mar0x/patch_mate/docs/images/image17.jpg

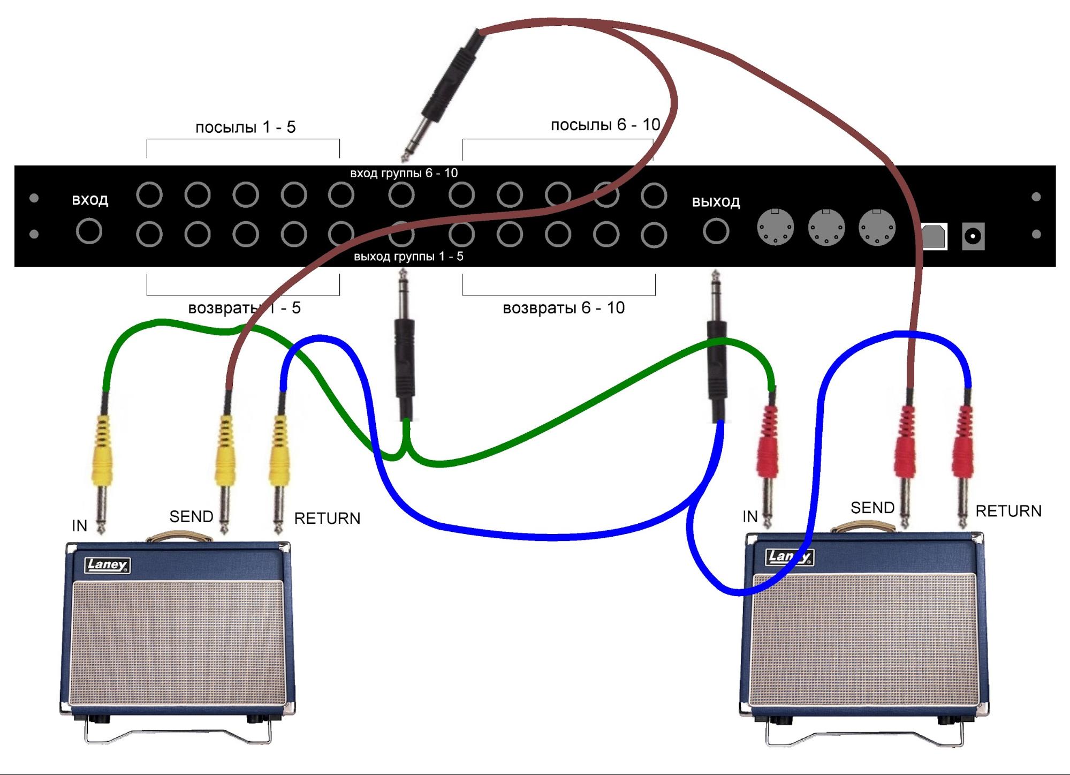
docs/images/image17.jpg
