mar0x/patch_mate/docs/images/image10.png

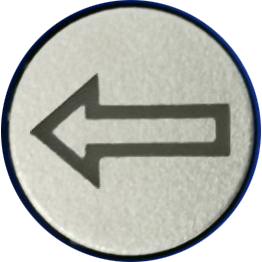
docs/images/image10.png
