mar0x/patch_mate/CHANGELOG.md

## Version FW-2021.12.26

### Bug fixes

- some SysEx messages may pass incomplete from MIDI to USB;

## Version FW-2021.12.24

### New features

- change active preset with encoder, holding LEFT key is optional;
