mar0x/patch_mate/img/Надписи 2.pdf

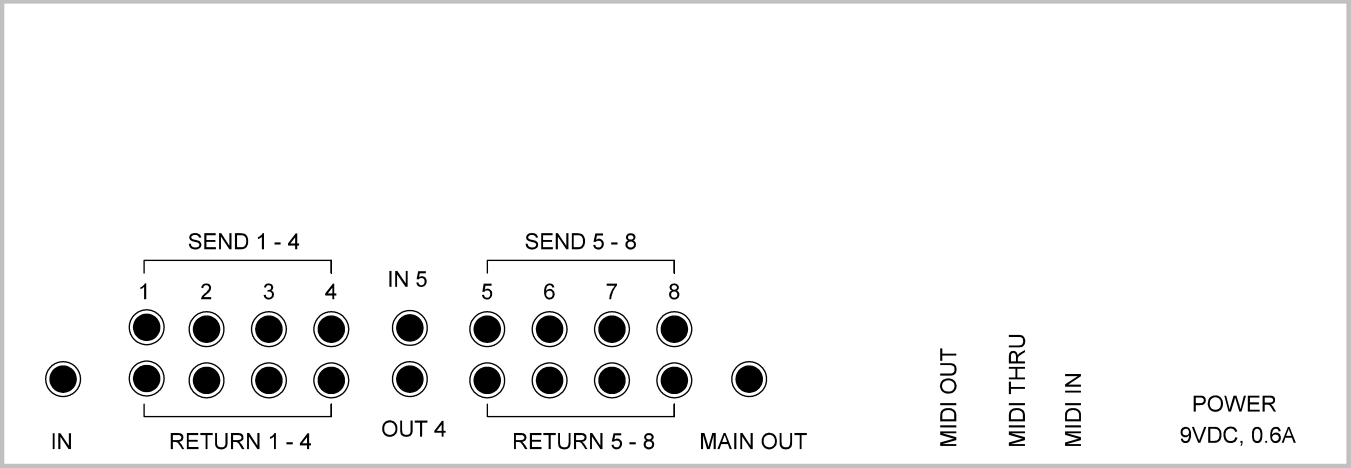
[picture p34: page 1]
