mar0x/patch_mate/docs/images/image13.jpg

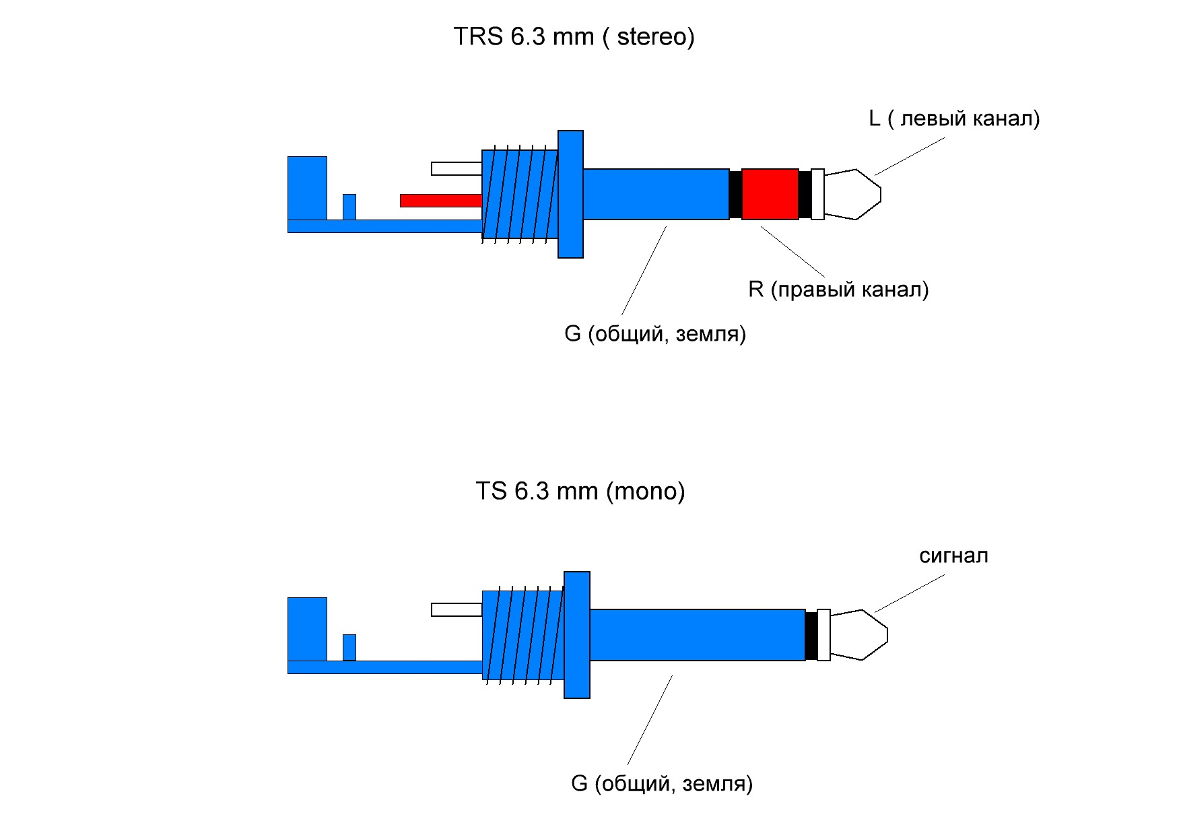
docs/images/image13.jpg
