mar0x/patch_mate/img/patch_mate_8_face.png

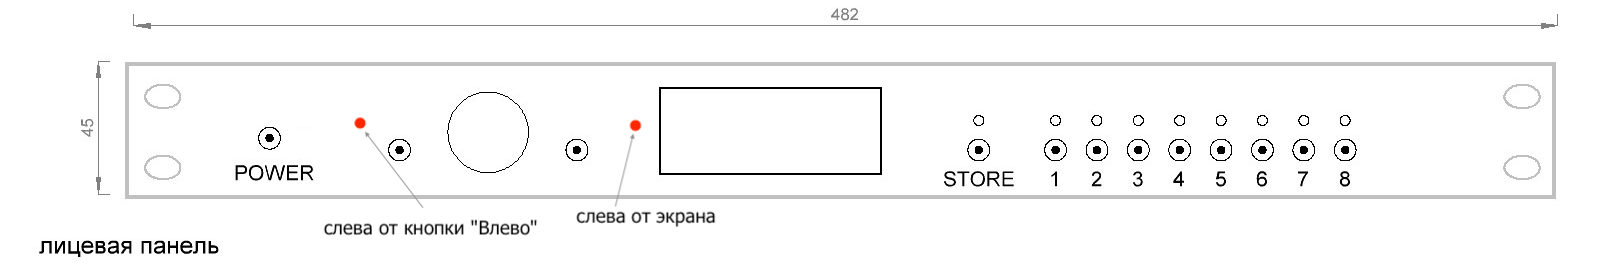
img/patch_mate_8_face.png
