mar0x/patch_mate/img/компоновка 3.JPG

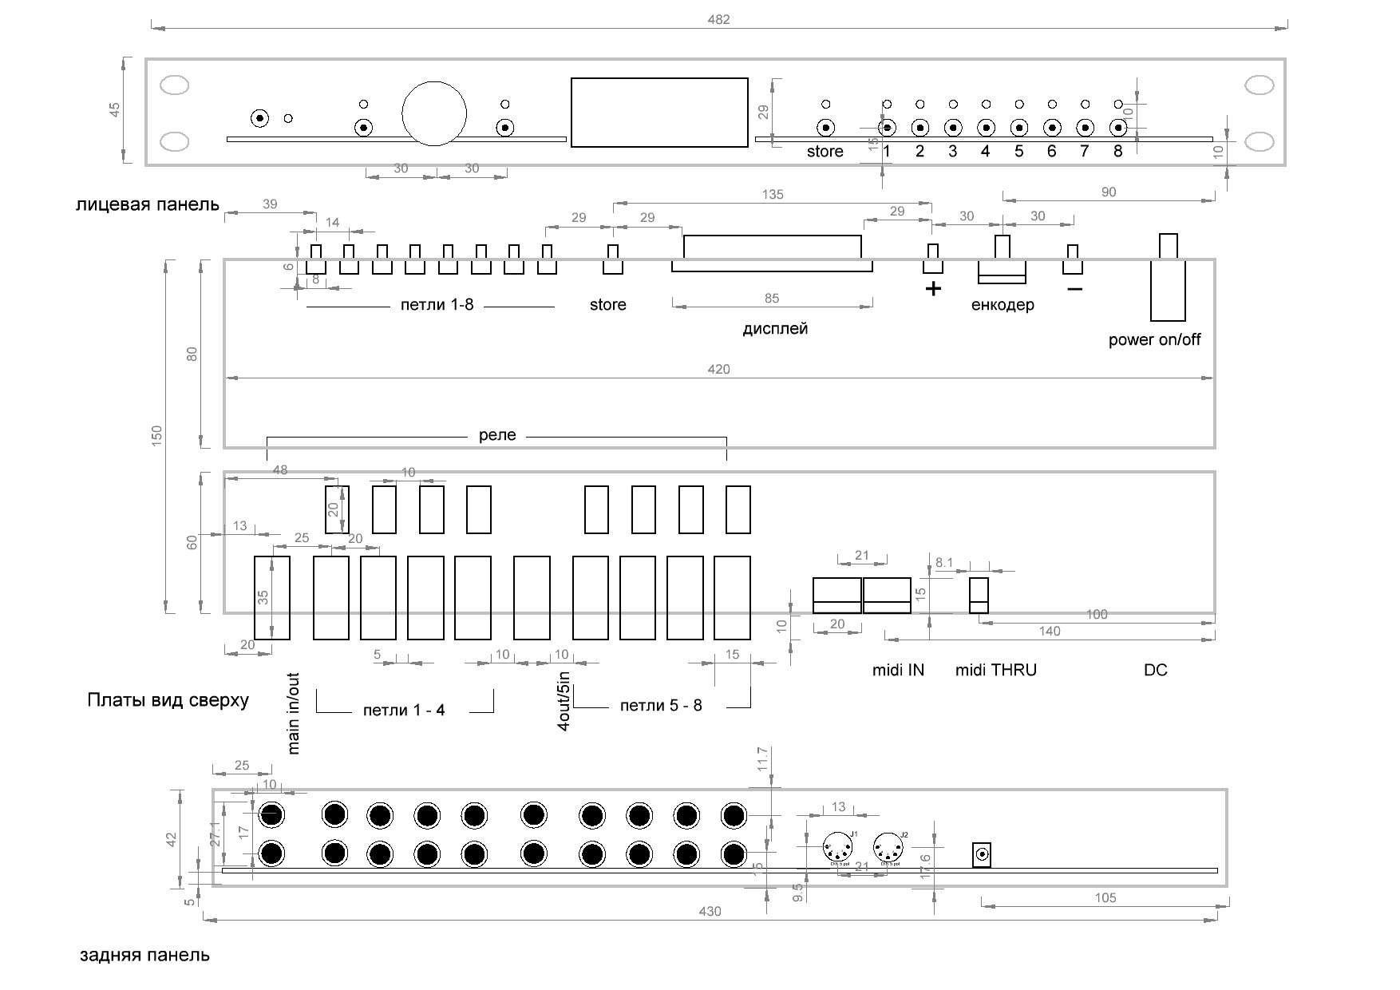
img/компоновка 3.JPG
