mar0x/patch_mate/img/компоновка 4.JPG

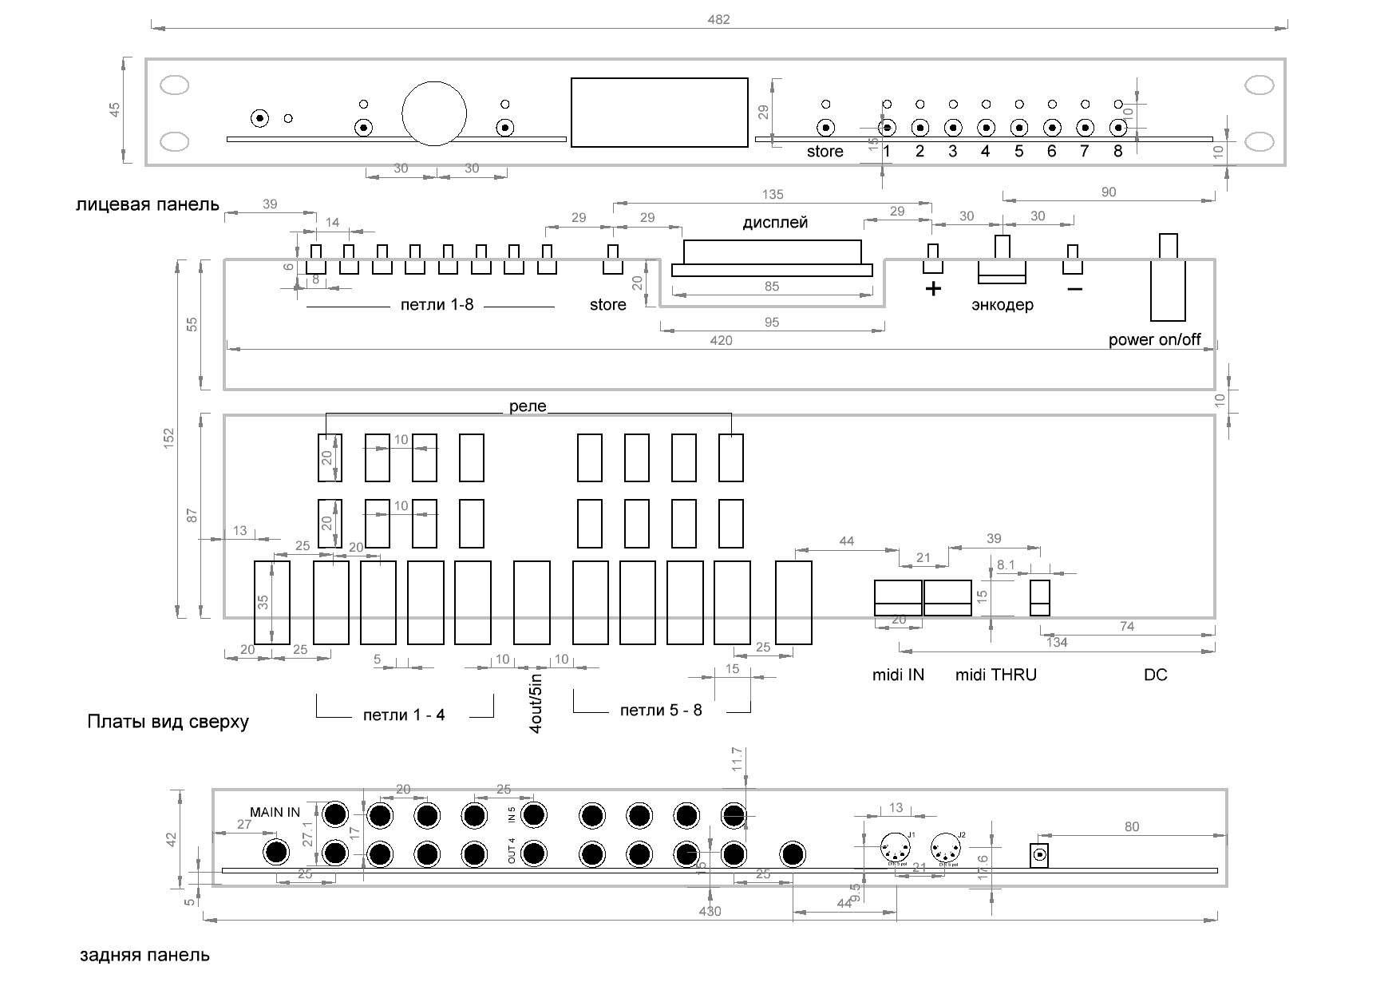
img/компоновка 4.JPG
