mar0x/patch_mate/img/надписи на крышке.JPG

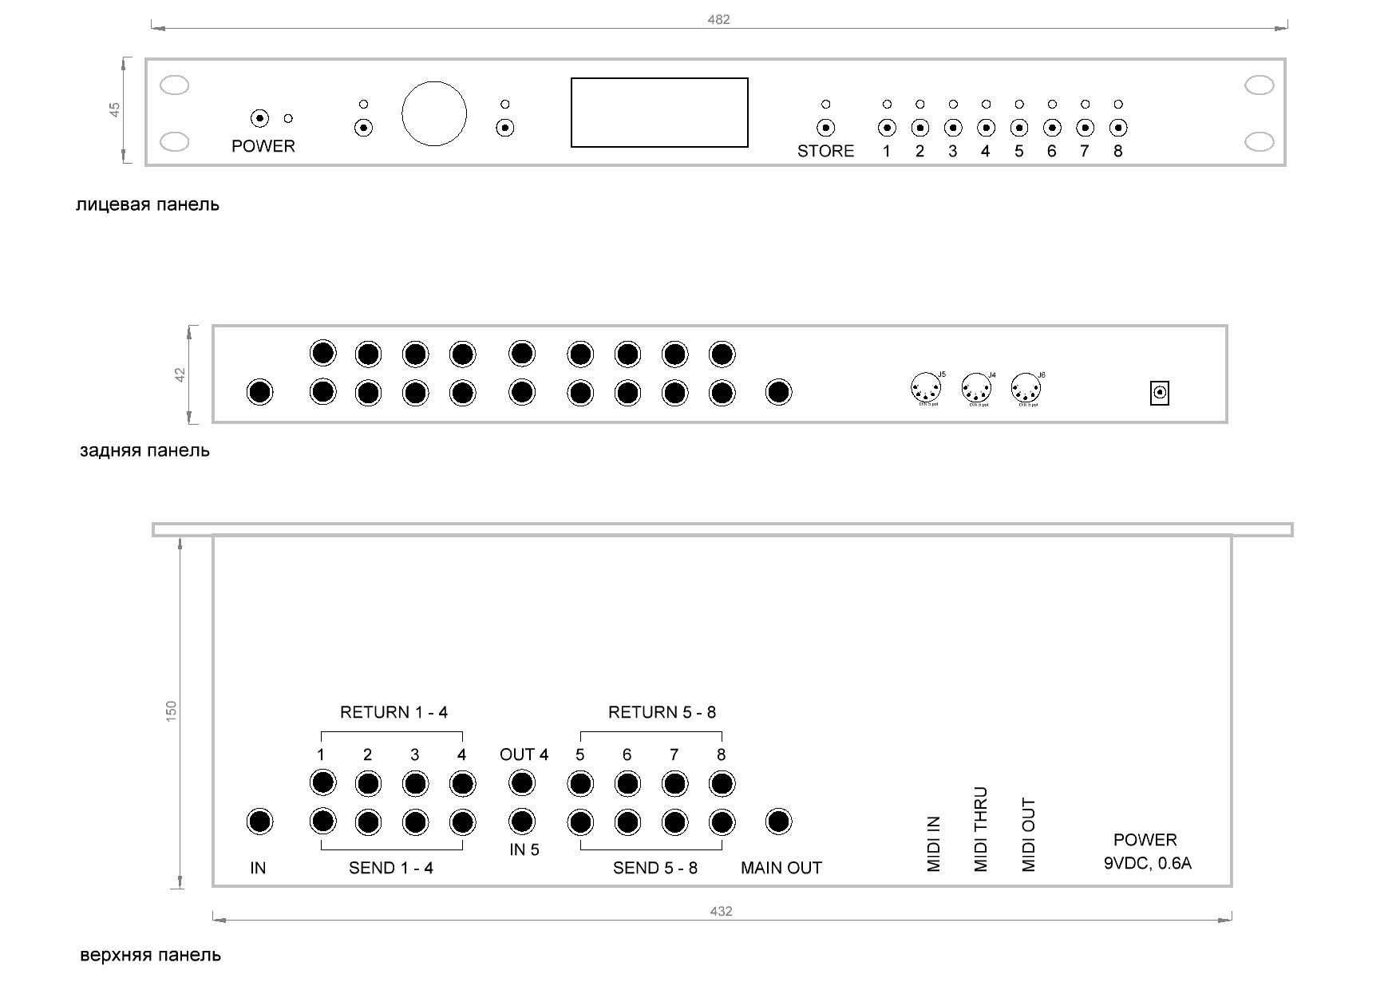
img/надписи на крышке.JPG
