mar0x/patch_mate/patch_mate-bom.xlsx

id | q | ref | desc | size | Vendor |  | Order info
 |  |  |  |  | URL | code | # | date | price | count | shipping | cost | cost per item
Control board
22 pF | 2 | C1,C2 | Кер.ЧИП конд. 22пФ NPO 50В, 5% | 0805 | CC0805JRNPO9BN220 (https://www.terraelectronica.ru/product/540614) | #540614 (https://www.terraelectronica.ru/product/540614) |  |  | 0.40 | 1 |  | 0.40 | 0.80
0.1 uF | 9 | C3,C5,C6,C7,C8,C9,C10,C11,C12 | Кер.ЧИП конд. 0.1 мкФ X7R 50В, 10% | 0805 | 08051C104KAT2A (https://www.terraelectronica.ru/product/684373) | #684373 (https://www.terraelectronica.ru/product/684373) |  |  | 1.20 | 1 |  | 1.20 | 10.80
1 uF | 1 | C4 | Кер.ЧИП конд. 1 мкФ X7R 16В, 10% | 0805 | CC0805KKX7R7BB105 (https://www.terraelectronica.ru/product/576615) | #576615 (https://www.terraelectronica.ru/product/576615) |  |  | 0.59 | 1 |  | 0.59 | 0.59
JST B2B-XH-A | 1 | J1 | 2.5mm |  | JST XH 2.5 mm 2 pin (https://aliexpress.ru/item/32823245600.html) |  |  |  | 1.45 | 100 | 75.00 | 220.00 | 2.20
JST B11B-PH-K-S | 1 | J2 | 2.0mm |  | JST 2.0 mm 11 pin (https://aliexpress.ru/item/33013582664.html) |  | #5003346814132510 (https://trade.aliexpress.ru/order_detail.htm?orderId=5003346814132510) | 2020-03-11 | 10.31 | 20 |  | 206.13 | 10.31
JST B4B-PH-K-S | 1 | J3 | 2.0mm |  | JST 2.0 mm 4 pin (https://aliexpress.ru/item/33013582664.html) |  | #5003346814132510 (https://trade.aliexpress.ru/order_detail.htm?orderId=5003346814132510) | 2020-03-11 | 5.85 | 20 |  | 117.10 | 5.85
JST B5B-PH-K-S | 1 | J4 | 2.0mm |  | JST 2.0 mm 5 pin (https://aliexpress.ru/item/33013582664.html) |  | #5003346814132510 (https://trade.aliexpress.ru/order_detail.htm?orderId=5003346814132510) | 2020-03-11 | 6.50 | 20 |  | 129.93 | 6.50
DS1013-06S | 1 | J5 | Вилка на плату прямая 6 конт. 2.54мм |  | DS1013-06SSiB1-B-0 (https://www.terraelectronica.ru/product/2739747) | #2739747 (https://www.terraelectronica.ru/product/2739747) |  |  | 3.90 | 1 |  | 3.90 | 3.90
JST B6B-PH-K-S | 1 | J6 | 2.0mm |  | JST 2.0 mm 6 pin (https://aliexpress.ru/item/33013582664.html) |  | #5003346814132510 (https://trade.aliexpress.ru/order_detail.htm?orderId=5003346814132510) | 2020-03-11 | 7.18 | 20 |  | 143.57 | 7.18
JST B7B-PH-K-S | 1 | J7 | 2.0mm |  | JST 2.0 mm 7 pin (https://aliexpress.ru/item/33013582664.html) |  | #5003346814132510 (https://trade.aliexpress.ru/order_detail.htm?orderId=5003346814132510) | 2020-03-11 | 7.94 | 20 |  | 158.80 | 7.94
1 kOhm | 13 |  | Чип резистор (SMD), 1 кОм, 0.125Вт, 1% | 0805 | RC0805FR-071KL (https://www.terraelectronica.ru/product/564131) | #564131 (https://www.terraelectronica.ru/product/564131) |  |  | 0.17 | 1 |  | 0.17 | 2.21
22 Ohm | 2 | R12,R13 | Чип резистор (SMD), 22 Ом, 0.125Вт, 1% | 0805 | RC0805FR-0722RL (https://www.terraelectronica.ru/product/851624) | #851624 (https://www.terraelectronica.ru/product/851624) |  |  | 0.12 | 1 |  | 0.12 | 0.24
10 kOhm | 2 | R14,R15 | Чип резистор (SMD), 10 кОм, 0.125Вт, 1% | 0805 | RC0805FR-0710KL (https://www.terraelectronica.ru/product/358763) | #358763 (https://www.terraelectronica.ru/product/358763) |  |  | 0.17 | 1 |  | 0.17 | 0.34
39 kOhm | 15 |  | Чип резистор (SMD), 39 кОм, 0.125Вт, 1% | 0805 | CR-05FL7---39K (https://www.terraelectronica.ru/product/2782305) | #2782305 (https://www.terraelectronica.ru/product/2782305) |  |  | 0.13 | 1 |  | 0.13 | 1.95
PEC16-2215F-N0024 | 1 |  | Энкодер инкрементный |  | PEC16-2215F-N0024 (https://www.terraelectronica.ru/product/577148) | #577148 (https://www.terraelectronica.ru/product/577148) |  |  | 44.80 | 1 |  | 44.80 | 44.80
ATmega32U4-AU | 1 | U1 | Микроконтроллер 8-Бит, AVR, 16МГц, 32КБ Flash, с USB контроллером | TQFP-44 | ATmega32U4 (https://aliexpress.ru/item/32916694199.html) |  | #3003806113682510 (https://trade.aliexpress.ru/order_detail.htm?orderId=3003806113682510) |  | 228.80 | 5 |  | 1144.00 | 228.80
74HC595 | 3 | U2,U6,U7 | 8-и битный сдвиговый регистр с выходным регистром-защелки и тремя состояниями | SO-16 | SN74HC595DR (https://www.terraelectronica.ru/product/36946) | #36946 (https://www.terraelectronica.ru/product/36946) |  |  | 10.30 | 1 |  | 10.30 | 30.90
USBLC6-2SC6 | 1 | U3 | Защита интерфейса USB от электростатических разрядов | SOT-23-6 | USBLC6-2SC6 (https://www.terraelectronica.ru/product/244787) | #244787 (https://www.terraelectronica.ru/product/244787) |  |  | 4.70 | 1 |  | 4.70 | 4.70
74HC165 | 2 | U4,U5 | 8-битный сдвиговый регистр с параллельным входом, последовательным выходом | SO-16 | SN74HC165DR (https://www.terraelectronica.ru/product/51304) | #51304 (https://www.terraelectronica.ru/product/51304) |  |  | 8.00 | 1 |  | 8.00 | 16.00
AT25640B | 1 | U8 | Микросхема памяти, 64Kb SPI-compatible Serial EEPROM | SO-8 | AT25640B-SSHL-T (https://www.terraelectronica.ru/product/679087) | #679087 (https://www.terraelectronica.ru/product/679087) |  |  | 20.00 | 1 |  | 20.00 | 20.00
SN74LVC1G125DBVR | 1 | U9 | Один буферный элемент с тремя состояниями на выходе | SOT-23-5 | SN74LVC1G125DBVR (https://www.terraelectronica.ru/product/32503) | #32503 (https://www.terraelectronica.ru/product/32503) |  |  | 2.70 | 1 |  | 2.70 | 2.70
HC-49SM | 1 | Y1 | Кварцевый резонатор, 16.000 МГц | HC-49SM | HC-49SM (https://www.chipdip.ru/product/16mhz-hc-49sm) | #375027481 (https://www.chipdip.ru/product/16mhz-hc-49sm) |  |  | 18.00 | 1 |  | 18.00 | 18.00
Relay board
100 uF | 1 | C1 | Конденсатор электролитический алюминиевый, ECAP (К50-35), 100 мкФ, 25 В, 20% | 6.3x11mm | JRC1E101M02500630110000B (https://www.chipdip.ru/product0/9000565756) | #9000565756 (https://www.chipdip.ru/product0/9000565756) |  |  | 5.00 | 1 |  | 5.00 | 5.00
1000 uF | 1 | C2 | Конденсатор электролитический алюминиевый, ECAP (К50-35), 1000 мкФ, 16 В | 10x16mm | B41851A4108M000 (https://www.chipdip.ru/product0/9000306686) | #9000306686 (https://www.chipdip.ru/product0/9000306686) |  |  | 32.00 | 1 |  | 32.00 | 32.00
0.1 uF | 5 | C3,C4,C5,C6,C7 | Кер.ЧИП конд. 0.1 мкФ X7R 50В, 10% | 0805 | 08051C104KAT2A (https://www.terraelectronica.ru/product/684373) | #684373 (https://www.terraelectronica.ru/product/684373) |  |  | 1.20 | 1 |  | 1.20 | 6.00
RS202-BP | 1 | D3 | Diode bridge, +ve/AC/AC/-ve | RS2 | RS202-BP (https://www.terraelectronica.ru/product/2740393) | #2740393 (https://www.terraelectronica.ru/product/2740393) |  |  | 9.70 | 1 |  | 9.70 | 9.70
D | 1 | D4 | Диод импульсный 75 мА 75В 5нс | SOD323F/SC-90 | BAS316.115 (https://www.terraelectronica.ru/product/241389) | #241389 (https://www.terraelectronica.ru/product/241389) |  |  | 0.65 | 1 |  | 0.65 | 0.65
1N5822 | 1 | D5 | Диод Шоттки 40В 3А/80А | DO-201AE | 1N5822 (https://www.terraelectronica.ru/product/154029) | #154029 (https://www.terraelectronica.ru/product/154029) |  |  | 7.20 | 1 |  | 7.20 | 7.20
MF-MSMF050-2 | 1 | F1 | Предохранитель USB VBUS | 1812 | MF-MSMF050-2 (https://www.terraelectronica.ru/product/186713) | #186713 (https://www.terraelectronica.ru/product/186713) |  |  | 2.10 | 1 |  | 2.10 | 2.10
DualJack | 11 |  |  |  | CK635-037 (https://aliexpress.ru/item/32756961680.html) |  | #3003695040752510 (https://trade.aliexpress.ru/order_detail.htm?orderId=3003695040752510) |  | 115.00 | 10 |  | 1150.00 | 1265.00
RTW909080M | 3 | J1,J2,J3 | DIN connector 5 Pin DIN Female Jack Right Angle Panel Mount 90 Degree |  | RTW909080M (https://www.aliexpress.ru/item/10-Pcs-Set-PCB-Panel-Mount-Female-Connector-DIN5-DIN-5-Pin-Jack-DS-5-01/4001264257087.html) |  | #5005159492622510 (https://trade.aliexpress.ru/order_detail.htm?orderId=5005159492622510) | 2020-08-27 | 23.05 | 60 | 141.74 | 1524.86 | 76.24
DS-210B | 1 | J4 | Гнездо питания 2,1х5,5мм на панель |  | DS-210B (https://www.terraelectronica.ru/product/2584473) | #2584473 (https://www.terraelectronica.ru/product/2584473) |  |  | 10.50 | 1 |  | 10.50 | 10.50
JST B2B-XH-A | 1 | J5 | 2.5mm |  | JST XH 2.5 mm 2 pin (https://aliexpress.ru/item/32823245600.html) |  |  |  | 1.45 | 100 |  | 145.00 | 1.45
JST B5B-PH-K-S | 1 | J6 | 2.0mm |  | JST 2.0 mm 5 pin (https://aliexpress.ru/item/33013582664.html) |  | #5003346814132510 (https://trade.aliexpress.ru/order_detail.htm?orderId=5003346814132510) | 2020-03-11 | 6.50 | 20 |  | 129.93 | 6.50
JST B4B-PH-K-S | 1 | J7 | 2.0mm |  | JST 2.0 mm 4 pin (https://aliexpress.ru/item/33013582664.html) |  | #5003346814132510 (https://trade.aliexpress.ru/order_detail.htm?orderId=5003346814132510) | 2020-03-11 | 5.85 | 20 |  | 117.10 | 5.85
JST B4B-XH-A | 1 | J8 | 2.5mm |  | JST XH 2.5 mm 4 pin (https://aliexpress.ru/item/32823245600.html) |  |  |  | 2.07 | 70 |  | 145.00 | 2.07
DS1099 | 1 | J9 | Розетка на плату, тип B (черная) угловая |  | DS1099-BN0 (https://www.chipdip.ru/product/usbb-1j-ds1099-b) | #846814658 (https://www.chipdip.ru/product/usbb-1j-ds1099-b) |  |  | 21.00 | 1 |  | 21.00 | 21.00
 |  |  |  |  | USBB-1J (https://www.terraelectronica.ru/product/1209523) | #1209523 (https://www.terraelectronica.ru/product/1209523) |  |  | 6.10 | 1 |  | 6.10 | 0.00
 |  |  |  |  |  | #2123217 (https://www.terraelectronica.ru/product/2123217) |  |  | 11.10 | 1 |  | 11.10 | 0.00
JST B11B-PH-K-S | 1 | J10 | 2.0mm |  | JST 2.0 mm 11 pin (https://aliexpress.ru/item/33013582664.html) |  | #5003346814132510 (https://trade.aliexpress.ru/order_detail.htm?orderId=5003346814132510) | 2020-03-11 | 10.31 | 20 |  | 206.13 | 10.31
G6K-2F-Y | 22 |  | Relay |  | G6K2FYTR5DC (https://www.terraelectronica.ru/product/322403) |  | #06867934 (https://www.terraelectronica.ru/order/06867934) |  | 129.00 | 20 |  | 2580.00 | 2838.00
100 uH | 1 | L1 | Катушка индуктивности, КИ (КИГ) 3.0-100 мкГн, 10%-20% |  | КИГ3.0-100мкГн (https://www.chipdip.ru/product0/44315) | #44315 (https://www.chipdip.ru/product0/44315) |  |  | 120.00 | 1 |  | 120.00 | 120.00
CK635-041A |  |  | Audio Jack, 3 Poles (Stereo / TRS) |  | AudioJack Socket (https://aliexpress.ru/item/32973696420.html) |  | #8003284014042510 (https://trade.aliexpress.ru/order_detail.htm?orderId=8003284014042510) | 2019-09-30 | 40.00 | 5 |  | 200.00 | 0.00
 | 2 |  |  |  | Audio Jack Socket (https://aliexpress.ru/item/10pcs-1-4-6-35-mm-stereo-phone-Jack-socket-Headphone-Connector-3-conductor-6-contact/32757700155.html) |  | #5007690877382510 (https://trade.aliexpress.ru/order_detail.htm?orderId=5007690877382510) | 2020-12-23 | 87.80 | 10 |  | 878.00 | 175.60
PMV65XP,215 | 2 | Q2,Q3 | Транзистор MOSFET P-CH 20V 3.9A 76 mOhm | SOT-23-3 | PMV65XP.215 (https://www.terraelectronica.ru/product/212641) | #212641 (https://www.terraelectronica.ru/product/212641) |  |  | 2.70 | 1 |  | 2.70 | 5.40
470 Ohm | 5 | R1,R2,R3,R4,R8 | Чип резистор (SMD), 470 Ом, 0.125Вт, 1%, 0805 | 0805 | RC0805FR-07470RL (https://www.terraelectronica.ru/product/669838) | #669838 (https://www.terraelectronica.ru/product/669838) |  |  | 0.15 | 1 |  | 0.15 | 0.75
39 kOhm | 1 | R5 | Чип резистор (SMD), 39 кОм, 0.125Вт, 1%, 0805 | 0805 | CR-05FL7---39K (https://www.terraelectronica.ru/product/2782305) | #2782305 (https://www.terraelectronica.ru/product/2782305) |  |  | 0.13 | 1 |  | 0.13 | 0.13
220 Ohm | 5 | R6,R10,R11,R12,R13 | Чип резистор (SMD), 220 Ом, 0.125Вт, 1%, 0805 | 0805 | CR-05FL7--220R (https://www.terraelectronica.ru/product/2782271) | #2782271 (https://www.terraelectronica.ru/product/2782271) |  |  | 0.12 | 1 |  | 0.12 | 0.60
100 kOhm | 1 | R7 | Чип резистор (SMD), 100 кОм, 0.125Вт, 1%, 0805 | 0805 | RC0805FR-07100KL (https://www.terraelectronica.ru/product/359706) | #359706 (https://www.terraelectronica.ru/product/359706) |  |  | 0.17 | 1 |  | 0.17 | 0.17
10 kOhm | 1 | R9 | Чип резистор (SMD), 10 кОм, 0.125Вт, 1%, 0805 | 0805 | RC0805FR-0710KL (https://www.terraelectronica.ru/product/358763) | #358763 (https://www.terraelectronica.ru/product/358763) |  |  | 0.17 | 1 |  | 0.17 | 0.17
ULN2003 | 2 | U1,U6 | Матрица из семи транзисторов Дарлингтона, 500мА | SO-16 | ULN2003AFWG (https://www.terraelectronica.ru/product/183737) | #183737 (https://www.terraelectronica.ru/product/183737) |  |  | 16.60 | 1 |  | 16.60 | 33.20
LM2576HVT-5.0 |  | U3 | Импульсный понижающий регулятор напряжения, 5В, 3А | TO-220-5 | LM2576HVT-5.0 (https://www.chipdip.ru/product/lm2576hvt-5.0-nopb) |  |  |  | 370.00 | 1 |  | 370.00 | 0.00
 | 1 |  |  |  |  | #32785463847 (https://aliexpress.ru/item/32785463847.html) | #94453833502510 (https://trade.aliexpress.ru/order_detail.htm?orderId=94453833502510) | 2018-09-03 | 12.62 | 10 | 63.10 | 189.30 | 18.93
6N138M | 1 | U4 | Оптопара с транзисторным выходом | SMD DIP-8 | 6N138M (https://www.aliexpress.com/item/10pcs-lot-6N135-6N136-6N137-6N138-6N139-DIP-8-SMD-8/32874392571.html) |  | #5005159492502510 (https://trade.aliexpress.ru/order_detail.htm?orderId=5005159492502510) | 2020-08-27 | 8.88 | 10 | 53.74 | 142.52 | 14.25
SN74LVC1G125DBVR | 3 | U5,U7,U8 | Один буферный элемент с тремя состояниями на выходе | SOT-23-5 | SN74LVC1G125DBVR (https://www.terraelectronica.ru/product/32503) | #32503 (https://www.terraelectronica.ru/product/32503) |  |  | 2.70 | 1 |  | 2.70 | 8.10
Other
1602 OLED | 1 |  |  |  | 1602 OLED (https://aliexpress.ru/item/32833284534.html) |  | 5003448406902510 (https://trade.aliexpress.ru/order_detail.htm?orderId=5003448406902510) |  | 1050.00 | 1 | 280.00 | 1330.00 | 1330.00
6x6x7 Tact Button | 13 |  |  |  | 6x6x7 Tact Button (https://aliexpress.ru/item/32842913674.html) |  | 3003743130452510 (https://trade.aliexpress.ru/order_detail.htm?orderId=3003743130452510) | 2020-04-17 | 75.00 | 1 |  | 75.00 | 975.00
Button Cap | 13 |  |  |  | Button Cap 10 mm (https://aliexpress.ru/item/32844358663.html) |  |  |  | 55.00 | 1 |  | 55.00 | 715.00
PCB | 1 |  |  |  |  |  |  |  | 311.00 | 5 | 1500.00 | 3055.00 | 611.00
Button Board PCB | 1 |  |  |  |  |  |  |  | 657.60 | 5 |  | 3288.00 | 657.60
Power Switch | 1 |  |  |  | Latched Button, 16 mm, Green, 5v (https://aliexpress.ru/item/32800996847.html) |  | #93387171242510 (https://trade.aliexpress.ru/order_detail.htm?orderId=93387171242510) | 2018-07-31 | 144.00 | 1 |  | 144.00 | 144.00
 |  |  |  |  |  |  |  |  |  |  |  |  | 9536.18
