mar0x/patch_mate/KiCad/relay_board/relay_board_schem.pdf

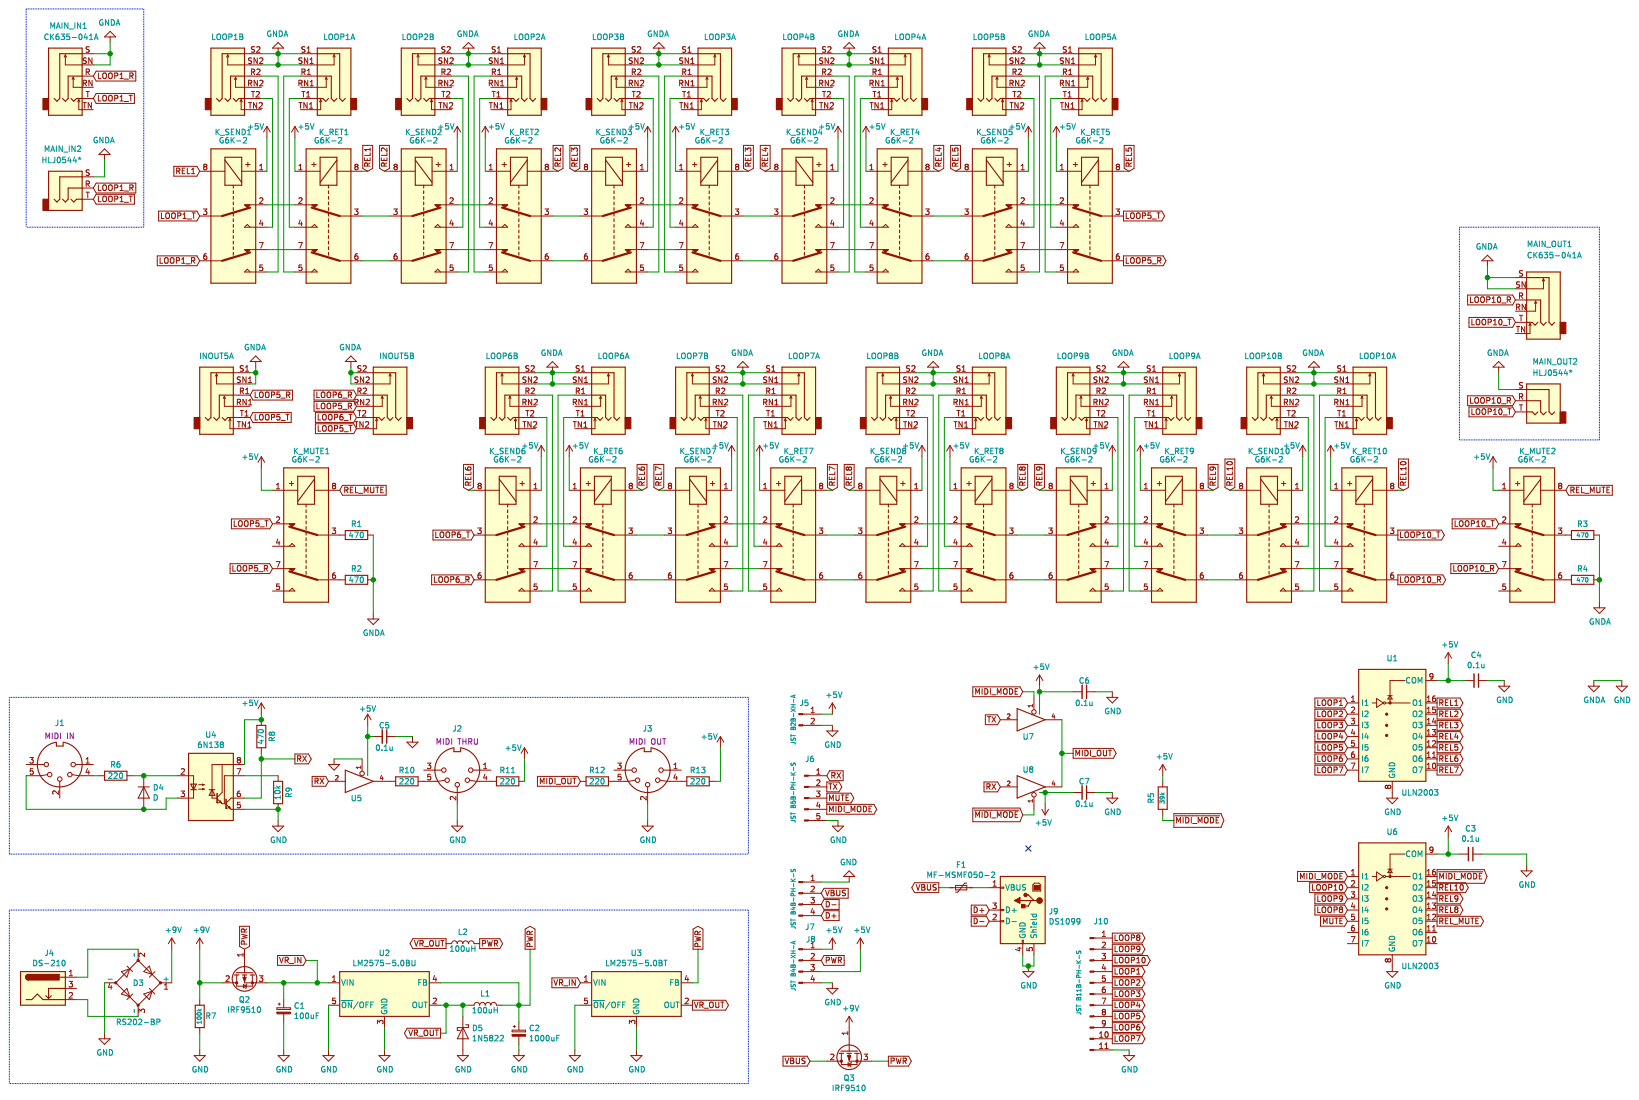
[picture p40: page 1]
