mar0x/patch_mate/KiCad/relay_board/relay_board.kicad_pcb

## KiCad design KiCad/relay_board/relay_board.kicad_pcb (2020-10-22)

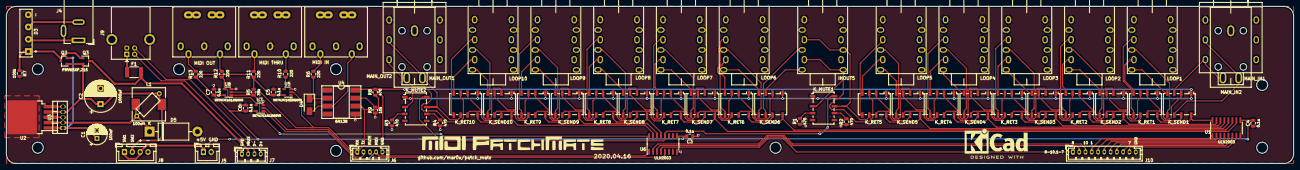
[picture p41: board relay_board.kicad_pcb from above]

Board: 2 copper layers, 410.0 x 50.0 mm, 83 parts (0 on the bottom side), 136 nets.

Parts:
C1: 100uF; CP_Radial_D6.3mm_P2.50mm
C2: 1000uF; CP_Radial_D10.0mm_P5.00mm
C3, C4, C5, C6, C7: 0.1u; C_0805_2012Metric
D3: RS202-BP; Diode_Bridge_KBP20x
D4: D; D_SMA
D5: 1N5822; D_DO-201AD_P15.24mm_Horizontal
F1: MF-MSMF050-2; Fuse_1812_4532Metric_Pad1.30x3.40mm_HandSolder
INOUT5: AudioJack3_Dual_Switch; CK635-037
J1, J2, J3: DIN5MIDI-OOTDTY
J4: DS-210; BarrelJack_Wuerth_6941xx301002
J5: JST B2B-XH-A; JST_XH_B2B-XH-A_1x02_P2.50mm_Vertical
J6: JST B5B-PH-K-S; JST_PH_B5B-PH-K_1x05_P2.00mm_Vertical
J7: JST B4B-PH-K-S; JST_PH_B4B-PH-K_1x04_P2.00mm_Vertical
J8: JST B4B-XH-A; JST_XH_B4B-XH-A_1x04_P2.50mm_Vertical
J9: DS1099; USB_B_OST_USB-B1HSxx_Horizontal
J10: JST B11B-PH-K-S; JST_PH_B11B-PH-K_1x11_P2.00mm_Vertical
K_MUTE1, K_MUTE2: G6K-2; Relay_DPDT_Omron_G6K-2F-Y
K_RET1, K_RET2, K_RET3, K_RET4, K_RET5, K_RET6, K_RET7, K_RET8, K_RET9, K_RET10: G6K-2; Relay_DPDT_Omron_G6K-2F-Y
K_SEND1, K_SEND2, K_SEND3, K_SEND4, K_SEND5, K_SEND6, K_SEND7, K_SEND8, K_SEND9, K_SEND10: G6K-2; Relay_DPDT_Omron_G6K-2F-Y
L1: 100uH; L_10.4x10.4_H4.8
L2: 100uH; L_Axial_L7.0mm_D3.3mm_P10.16mm_Horizontal_Fastron_MICC
LOOP1, LOOP2, LOOP3, LOOP4, LOOP5, LOOP6, LOOP7, LOOP8, LOOP9, LOOP10: AudioJack3_Dual_Switch; CK635-037
MAIN_IN1: CK635-041A
MAIN_IN2: HLJ0544*; phone-jack-6.3
MAIN_OUT1: CK635-041A
MAIN_OUT2: HLJ0544*; phone-jack-6.3
Q2, Q3: PMV65XP,215; SOT-23
R1, R2, R3, R4, R8: 470; R_0805_2012Metric
R5: 39k; R_0805_2012Metric
R6, R10, R11, R12, R13: 220; R_0805_2012Metric
R7: 100k; R_0805_2012Metric
R9: 10k; R_0805_2012Metric
U1, U6: ULN2003; SOIC-16_3.9x9.9mm_P1.27mm
U2: LM2576S-5.0; TO-263-5_TabPin3
U3: LM2576HVT-5.0; TO-220-5_Vertical
U4: 6N138; DIP-8_W8.89mm_SMDSocket_LongPads
U5, U7, U8: SN74LVC1G125DBVR; SOT-23-5

Connections:
+5V: C3.2, C4.2, C5.2, C6.2, C7.2, J5.1, J8.1, J8.3, K_MUTE1.1, K_MUTE2.1, K_RET1.1, K_RET2.1, K_RET3.1, K_RET4.1, K_RET5.1, K_RET6.1, K_RET7.1, K_RET8.1, K_RET9.1, K_RET10.1, K_SEND1.1, K_SEND2.1, K_SEND3.1, K_SEND4.1, K_SEND5.1, K_SEND6.1, K_SEND7.1, K_SEND8.1, K_SEND9.1, K_SEND10.1, R5.2, R8.2, R11.1, R13.1, U1.9, U4.8, U5.5, U6.9, U7.5, U8.5
+9V: D3.1, Q2.3, Q3.1, R7.1
D+: J7.4, J9.3
D-: J7.3, J9.2
GND: C1.2, C2.2, C3.1, C4.1, C5.1, C6.1, C7.1, D3.4, D5.2, INOUT5.S1, INOUT5.S2, INOUT5.SN1, INOUT5.SN2, J2.2, J3.2, J5.2, J6.5, J7.1, J8.4, J9.4, J9.5, J10.11, LOOP1.S1, LOOP1.S2, LOOP1.SN1, LOOP1.SN2, LOOP2.S1, LOOP2.S2, LOOP2.SN1, LOOP2.SN2, LOOP3.S1, LOOP3.S2, LOOP3.SN1, LOOP3.SN2, LOOP4.S1, LOOP4.S2, LOOP4.SN1, LOOP4.SN2, LOOP5.S1, LOOP5.S2, LOOP5.SN1, LOOP5.SN2, LOOP6.S1, LOOP6.S2, LOOP6.SN1, LOOP6.SN2, LOOP7.S1, LOOP7.S2, LOOP7.SN1, LOOP7.SN2, LOOP8.S1, LOOP8.S2, LOOP8.SN1, LOOP8.SN2, LOOP9.S1, LOOP9.S2, LOOP9.SN1, LOOP9.SN2, LOOP10.S1, LOOP10.S2, LOOP10.SN1, LOOP10.SN2, MAIN_IN1.S, MAIN_IN1.SN, MAIN_IN2.S, MAIN_OUT1.S, MAIN_OUT1.SN, MAIN_OUT2.S, R1.1, R2.1, R3.1, R4.1, R7.2, R9.1, U1.8, U2.3, U2.5, U3.3, U3.5, U4.5, U5.1, U5.3, U6.8, U7.3, U8.3
LOOP1: J10.4, U1.1
LOOP1_R: K_SEND1.6, MAIN_IN1.R, MAIN_IN2.R
LOOP1_T: K_SEND1.3, MAIN_IN1.T, MAIN_IN2.T
LOOP2: J10.5, U1.2
LOOP3: J10.6, U1.3
LOOP4: J10.7, U1.4
LOOP5: J10.8, U1.5
LOOP5_R: INOUT5.R1, INOUT5.RN2, K_MUTE1.7, K_RET5.6
LOOP5_T: INOUT5.T1, INOUT5.TN2, K_MUTE1.2, K_RET5.3
LOOP6: J10.9, U1.6
LOOP6_R: INOUT5.R2, K_SEND6.6
LOOP6_T: INOUT5.T2, K_SEND6.3
LOOP7: J10.10, U1.7
LOOP8: J10.1, U6.4
LOOP9: J10.2, U6.3
LOOP10: J10.3, U6.2
LOOP10_R: K_MUTE2.7, K_RET10.6, MAIN_OUT1.R, MAIN_OUT2.R
LOOP10_T: K_MUTE2.2, K_RET10.3, MAIN_OUT1.T, MAIN_OUT2.T
MIDI_MODE: J6.4, U6.1, U7.1
MIDI_OUT: R12.2, U7.4, U8.4
MUTE: J6.3, U6.5
unnamed: D3.2, J4.1
unnamed: D3.3, J4.2
unnamed: D4.1, R6.1, U4.2
unnamed: D4.2, J1.5, U4.3
unnamed: F1.1, J9.1
unnamed: J1.4, R6.2
unnamed: J2.4, R11.2
unnamed: J2.5, R10.1
unnamed: J3.4, R13.2
unnamed: J3.5, R12.1
unnamed: K_MUTE1.3, R1.2
unnamed: K_MUTE1.6, R2.2
unnamed: K_MUTE2.3, R3.2
unnamed: K_MUTE2.6, R4.2
unnamed: K_RET1.2, K_SEND1.2
unnamed: K_RET1.3, K_SEND2.3
unnamed: K_RET1.4, LOOP1.T1
unnamed: K_RET1.5, LOOP1.R1
unnamed: K_RET1.6, K_SEND2.6
unnamed: K_RET1.7, K_SEND1.7
unnamed: K_RET2.2, K_SEND2.2
unnamed: K_RET2.3, K_SEND3.3
unnamed: K_RET2.4, LOOP2.T1
unnamed: K_RET2.5, LOOP2.R1
unnamed: K_RET2.6, K_SEND3.6
unnamed: K_RET2.7, K_SEND2.7
unnamed: K_RET3.2, K_SEND3.2
unnamed: K_RET3.3, K_SEND4.3
unnamed: K_RET3.4, LOOP3.T1
unnamed: K_RET3.5, LOOP3.R1
unnamed: K_RET3.6, K_SEND4.6
unnamed: K_RET3.7, K_SEND3.7
unnamed: K_RET4.2, K_SEND4.2
unnamed: K_RET4.3, K_SEND5.3
unnamed: K_RET4.4, LOOP4.T1
unnamed: K_RET4.5, LOOP4.R1
unnamed: K_RET4.6, K_SEND5.6
unnamed: K_RET4.7, K_SEND4.7
unnamed: K_RET5.2, K_SEND5.2
unnamed: K_RET5.4, LOOP5.T1
unnamed: K_RET5.5, LOOP5.R1
unnamed: K_RET5.7, K_SEND5.7
unnamed: K_RET6.2, K_SEND6.2
unnamed: K_RET6.3, K_SEND7.3
unnamed: K_RET6.4, LOOP6.T1
unnamed: K_RET6.5, LOOP6.R1
unnamed: K_RET6.6, K_SEND7.6
unnamed: K_RET6.7, K_SEND6.7
unnamed: K_RET7.2, K_SEND7.2
unnamed: K_RET7.3, K_SEND8.3
unnamed: K_RET7.4, LOOP7.T1
unnamed: K_RET7.5, LOOP7.R1
unnamed: K_RET7.6, K_SEND8.6
unnamed: K_RET7.7, K_SEND7.7
unnamed: K_RET8.2, K_SEND8.2
unnamed: K_RET8.3, K_SEND9.3
unnamed: K_RET8.4, LOOP8.T1
unnamed: K_RET8.5, LOOP8.R1
unnamed: K_RET8.6, K_SEND9.6
unnamed: K_RET8.7, K_SEND8.7
unnamed: K_RET9.2, K_SEND9.2
unnamed: K_RET9.3, K_SEND10.3
unnamed: K_RET9.4, LOOP9.T1
unnamed: K_RET9.5, LOOP9.R1
unnamed: K_RET9.6, K_SEND10.6
unnamed: K_RET9.7, K_SEND9.7
unnamed: K_RET10.2, K_SEND10.2
unnamed: K_RET10.4, LOOP10.T1
unnamed: K_RET10.5, LOOP10.R1
unnamed: K_RET10.7, K_SEND10.7
unnamed: K_SEND1.4, LOOP1.T2
unnamed: K_SEND1.5, LOOP1.R2
unnamed: K_SEND2.4, LOOP2.T2
unnamed: K_SEND2.5, LOOP2.R2
unnamed: K_SEND3.4, LOOP3.T2
unnamed: K_SEND3.5, LOOP3.R2
unnamed: K_SEND4.4, LOOP4.T2
unnamed: K_SEND4.5, LOOP4.R2
unnamed: K_SEND5.4, LOOP5.T2
unnamed: K_SEND5.5, LOOP5.R2
unnamed: K_SEND6.4, LOOP6.T2
unnamed: K_SEND6.5, LOOP6.R2
unnamed: K_SEND7.4, LOOP7.T2
unnamed: K_SEND7.5, LOOP7.R2
unnamed: K_SEND8.4, LOOP8.T2
unnamed: K_SEND8.5, LOOP8.R2
unnamed: K_SEND9.4, LOOP9.T2
unnamed: K_SEND9.5, LOOP9.R2
unnamed: K_SEND10.4, LOOP10.T2
unnamed: K_SEND10.5, LOOP10.R2
unnamed: R9.2, U4.7
unnamed: R10.2, U5.4
PWR: C2.1, J8.2, L1.2, L2.2, Q2.1, Q3.2, U2.4, U3.4
REL1: K_RET1.8, K_SEND1.8, U1.16
REL2: K_RET2.8, K_SEND2.8, U1.15
REL3: K_RET3.8, K_SEND3.8, U1.14
REL4: K_RET4.8, K_SEND4.8, U1.13
REL5: K_RET5.8, K_SEND5.8, U1.12
REL6: K_RET6.8, K_SEND6.8, U1.11
REL7: K_RET7.8, K_SEND7.8, U1.10
REL8: K_RET8.8, K_SEND8.8, U6.13
REL9: K_RET9.8, K_SEND9.8, U6.14
REL10: K_RET10.8, K_SEND10.8, U6.15
REL_MUTE: K_MUTE1.8, K_MUTE2.8, U6.12
RX: J6.1, R8.1, U4.6, U5.2, U8.2
TX: J6.2, U7.2
VBUS: F1.2, J7.2, Q3.3
VR_IN: C1.1, Q2.2, U2.1, U3.1
VR_OUT: D5.1, L1.1, L2.1, U2.2, U3.2
~MIDI_MODE: R5.1, U6.16, U8.1
