mar0x/patch_mate/KiCad/button_board/button_board.kicad_pcb

## KiCad design KiCad/button_board/button_board.kicad_pcb (2020-05-05)

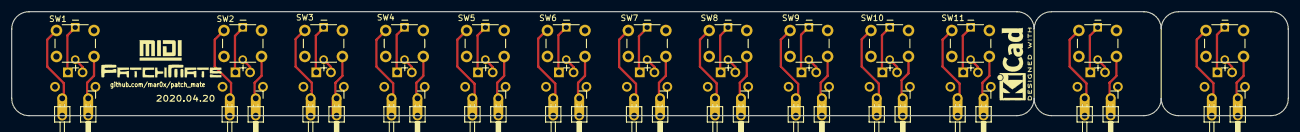
[picture p42: board button_board.kicad_pcb from above]

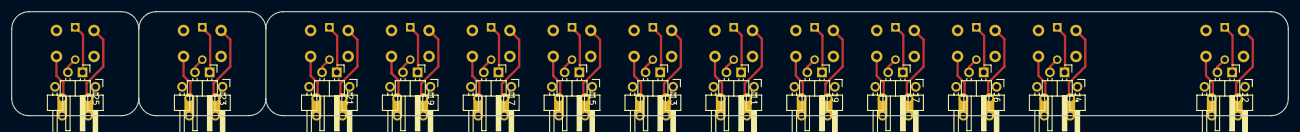
[picture p43: board button_board.kicad_pcb from below]

Board: 2 copper layers, 221.0 x 18.0 mm, 39 parts (13 on the bottom side), 52 nets.

Parts:
J1, J3, J5, J8, J10, J12, J14, J16, J18, J20, J22, J24, J26: Conn_01x02_Male; PinHeader_1x02_P4.5mm_Horizontal
J2, J4, J6, J7, J9, J11, J13, J15, J17, J19, J21, J23, J25: Conn_01x02_Male; PinHeader_1x02_P2.54mm_Horizontal
SW1, SW2, SW3, SW4, SW5, SW6, SW7, SW8, SW9, SW10, SW11, SW12, SW13: SW_MEC_5G_LED; SW_PUSH_6mm

Connections:
unnamed: J1.1, SW1.4
unnamed: J1.2, SW1.1
unnamed: J2.1, SW1.2
unnamed: J2.2, SW1.3
unnamed: J3.1, SW2.4
unnamed: J3.2, SW2.1
unnamed: J4.1, SW2.2
unnamed: J4.2, SW2.3
unnamed: J5.1, SW3.4
unnamed: J5.2, SW3.1
unnamed: J6.1, SW3.2
unnamed: J6.2, SW3.3
unnamed: J7.1, SW4.2
unnamed: J7.2, SW4.3
unnamed: J8.1, SW4.4
unnamed: J8.2, SW4.1
unnamed: J9.1, SW5.2
unnamed: J9.2, SW5.3
unnamed: J10.1, SW5.4
unnamed: J10.2, SW5.1
unnamed: J11.1, SW6.2
unnamed: J11.2, SW6.3
unnamed: J12.1, SW6.4
unnamed: J12.2, SW6.1
unnamed: J13.1, SW7.2
unnamed: J13.2, SW7.3
unnamed: J14.1, SW7.4
unnamed: J14.2, SW7.1
unnamed: J15.1, SW8.2
unnamed: J15.2, SW8.3
unnamed: J16.1, SW8.4
unnamed: J16.2, SW8.1
unnamed: J17.1, SW9.2
unnamed: J17.2, SW9.3
unnamed: J18.1, SW9.4
unnamed: J18.2, SW9.1
unnamed: J19.1, SW10.2
unnamed: J19.2, SW10.3
unnamed: J20.1, SW10.4
unnamed: J20.2, SW10.1
unnamed: J21.1, SW11.2
unnamed: J21.2, SW11.3
unnamed: J22.1, SW11.4
unnamed: J22.2, SW11.1
unnamed: J23.1, SW12.2
unnamed: J23.2, SW12.3
unnamed: J24.1, SW12.4
unnamed: J24.2, SW12.1
unnamed: J25.1, SW13.2
unnamed: J25.2, SW13.3
unnamed: J26.1, SW13.4
unnamed: J26.2, SW13.1
