mar0x/patch_mate/KiCad/control_board/control_board.kicad_pcb

## KiCad design KiCad/control_board/control_board.kicad_pcb (2020-05-05)

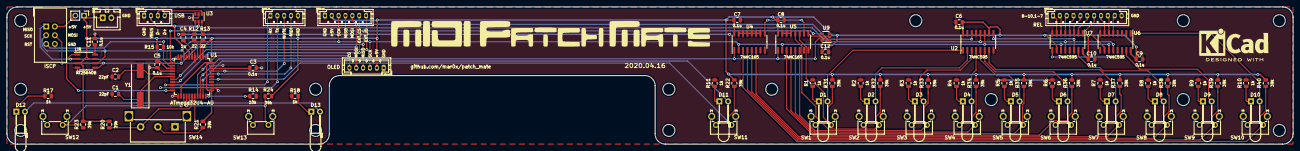
[picture p44: board control_board.kicad_pcb from above]

Board: 2 copper layers, 375.0 x 40.0 mm, 89 parts (0 on the bottom side), 83 nets.

Parts:
C1, C2: 22pF; C_0805_2012Metric
C3, C5, C6, C7, C8, C9, C10, C11, C12: 0.1u; C_0805_2012Metric
C4: 1u; C_0805_2012Metric
D1, D2, D3, D4, D5, D6, D7, D8, D9, D10, D11, D12, D13: LED; LED_D3.0mm_Horizontal_O6.35mm_Z10.0mm
J1: JST B2B-XH-A; JST_XH_B2B-XH-A_1x02_P2.50mm_Vertical
J2: JST B11B-PH-K-S; JST_PH_B11B-PH-K_1x11_P2.00mm_Vertical
J3: JST B4B-PH-K-S; JST_PH_B4B-PH-K_1x04_P2.00mm_Vertical
J4: JST B5B-PH-K-S; JST_PH_B5B-PH-K_1x05_P2.00mm_Vertical
J5: DS1013-06S; IDC-Header_2x03_P2.54mm_Vertical
J6: JST B6B-PH-K-S; JST_PH_B6B-PH-K_1x06_P2.00mm_Vertical
J7: JST B7B-PH-K-S; JST_PH_B7B-PH-K_1x07_P2.00mm_Vertical
J8: Conn_01x02_Male; PinHeader_1x02_P2.54mm_Vertical
R1, R2, R3, R4, R5, R6, R7, R8, R9, R10, R11, R17, R18: 1k; R_0805_2012Metric
R12, R13: 22; R_0805_2012Metric
R14, R15: 10k; R_0805_2012Metric
R20, R21, R22, R23, R24, R31, R32, R33, R34, R35, R36, R37, R38, R39, R40: 39k; R_0805_2012Metric
SW1, SW2, SW3, SW4, SW5, SW6, SW7, SW8, SW9, SW10, SW11, SW12, SW13: SW_Push; SW_Tactile_SPST_Angled_PTS645Vx83-2LFS
SW14: PEC16-2215F-N0024; RotaryEncoder_Bourns_PEC16-2215F-N0024_Vertical
U1: ATmega32U4-AU; TQFP-44_10x10mm_P0.8mm
U2, U6, U7: 74HC595; SOIC-16_3.9x9.9mm_P1.27mm
U3: USBLC6-2SC6; SOT-23-6
U4, U5: 74HC165; SOIC-16_3.9x9.9mm_P1.27mm
U8: AT25640B; SO-8_3.9x4.9mm_P1.27mm
U9: SN74LVC1G125DBVR; SOT-23-5
Y1: HC-49SM; Crystal_SMD_HC49-SD

Connections:
+5V: C5.1, C6.1, C7.1, C8.1, C9.1, C10.1, C11.1, C12.1, J1.1, J6.2, J7.2, J8.1, R15.1, R20.1, R21.1, R22.1, R23.1, R24.1, R31.1, R32.1, R33.1, R34.1, R35.1, R36.1, R37.1, R38.1, R39.1, R40.1, U1.2, U1.14, U1.24, U1.34, U1.44, U2.10, U2.16, U4.16, U5.16, U6.10, U6.16, U7.10, U7.16, U8.3, U8.7, U8.8, U9.5
D1: D1.2, U2.1
D2: D2.2, U2.2
D3: D3.2, U2.3
D4: D4.2, U2.4
D5: D5.2, U2.5
D6: D6.2, U2.6
D7: D7.2, U2.7
D8: D8.2, U7.15
D9: D9.2, U6.15
D10: D10.2, U6.1
D+: R12.1, U1.4
D-: R13.1, U1.3
D_MIDI: D12.2, D13.2, U1.27
D_STORE: D11.2, U1.32
EEPROM_CS: U1.22, U8.1
EXT_CS: J7.6, U1.19
EXT_IO: J7.7, U1.18
GND: C1.2, C2.2, C3.1, C4.1, C5.2, C6.2, C7.2, C8.2, C9.2, C10.2, C11.2, C12.2, J1.2, J2.11, J3.1, J4.5, J5.6, J6.1, J7.1, R1.1, R2.1, R3.1, R4.1, R5.1, R6.1, R7.1, R8.1, R9.1, R10.1, R11.1, R14.1, R17.1, R18.1, SW1.2, SW2.2, SW3.2, SW4.2, SW5.2, SW6.2, SW7.2, SW8.2, SW9.2, SW10.2, SW11.2, SW12.2, SW13.2, SW14.C, U1.5, U1.15, U1.23, U1.35, U1.43, U2.8, U2.13, U3.2, U4.8, U4.10, U4.11, U4.12, U4.13, U4.14, U4.15, U5.8, U5.13, U5.14, U5.15, U6.8, U6.13, U7.8, U7.13, U8.4, U9.3
ISCP_5V: J5.2, J8.2
LOOP1: J2.4, U7.4
LOOP2: J2.5, U7.3
LOOP3: J2.6, U7.2
LOOP4: J2.7, U7.1
LOOP5: J2.8, U6.7
LOOP6: J2.9, U6.6
LOOP7: J2.10, U6.5
LOOP8: J2.1, U7.7
LOOP9: J2.2, U7.6
LOOP10: J2.3, U7.5
MIDI_MODE: J4.4, U1.40
MISO: J5.1, J6.4, J7.4, U1.11, U8.2, U9.4
MOSI: J5.4, J6.5, J7.5, U1.10, U2.14, U8.5
MUTE: J4.3, U1.41
unnamed: C1.1, U1.17, Y1.1
unnamed: C2.1, U1.16, Y1.2
unnamed: C3.2, U1.42
unnamed: C4.2, U1.6
unnamed: D1.1, R1.2
unnamed: D2.1, R2.2
unnamed: D3.1, R3.2
unnamed: D4.1, R4.2
unnamed: D5.1, R5.2
unnamed: D6.1, R6.2
unnamed: D7.1, R7.2
unnamed: D8.1, R8.2
unnamed: D9.1, R9.2
unnamed: D10.1, R10.2
unnamed: D11.1, R11.2
unnamed: D12.1, R17.2
unnamed: D13.1, R18.2
unnamed: J3.3, U3.1
unnamed: J3.4, U3.3
unnamed: R12.2, U3.4
unnamed: R13.2, U3.6
unnamed: R14.2, U1.33
unnamed: U4.9, U5.10
unnamed: U5.9, U9.2
OLED_CS: J6.6, U1.30
REL_CS: U1.12, U2.12, U6.12, U7.12
RE_A: R20.2, SW14.A, U1.28
RE_B: R21.2, SW14.B, U1.29
RST: J5.5, R15.2, U1.13
RX: J4.1, U1.20
SCK: J5.3, J6.3, J7.3, U1.9, U2.11, U4.2, U5.2, U6.11, U7.11, U8.6
SER2: U2.9, U7.14
SER3: U6.14, U7.9
SW1: R31.2, SW1.1, U5.11
SW2: R32.2, SW2.1, U5.12
SW3: R33.2, SW3.1, U5.6
SW4: R34.2, SW4.1, U5.5
SW5: R35.2, SW5.1, U5.4
SW6: R36.2, SW6.1, U5.3
SW7: R37.2, SW7.1, U4.6
SW8: R38.2, SW8.1, U4.5
SW9: R39.2, SW9.1, U4.4
SW10: R40.2, SW10.1, U4.3
SW_CS: U1.31, U4.1, U5.1, U9.1
SW_LEFT: R23.2, SW12.1, U1.25
SW_RIGHT: R24.2, SW13.1, U1.26
SW_STORE: R22.2, SW11.1, U1.38
TX: J4.2, U1.21
VBUS: J3.2, U1.7, U3.5
