mar0x/patch_mate/(commit log)

2018-10-17 Fritzing files added
    [ControlBoard.fzz, RelayBoard.fzz]
2018-10-19 Added missing PCB connections
    [ControlBoard.fzz]
2018-10-19 Lite board added
    [PatchMateLite.fzz]
2018-10-26 Fixing loop 5-8 bits for full-size board
    [in.h]
2018-10-26 Removing outdated encoder connections
2019-02-15 One more small internal board for USB (B).
    [USBBoard.fzz]
2020-02-28 Adding gerber files for PCBs.
    [ControlBoard_contour.gm1, ControlBoard_copperBottom.gbl, ControlBoard_copperTop.gtl, ControlBoard_maskBottom.gbs, ControlBoard_maskTop.gts, ControlBoard_pasteMaskTop.gtp, ControlBoard_silkTop.gto, PatchMateLite_contour.gm1]
2020-02-28 Fixing dead aliexpress links.
    Adding Arduino Pro Micro link.
2020-02-28 Adding MIDI socket alternative link.
2020-03-08 Adding KiCad projects.
    [control_board.kicad_pcb, control_board.sch, relay_board.kicad_pcb, relay_board.sch]
2020-03-17 Adding 2 more channels.
    [control_board.kicad_pcb, control_board.sch, relay_board.kicad_pcb, relay_board.sch]
2020-03-17 Adding KBP20x diode bridge.
2020-03-17 Adding PEC16 encoder footprint.
2020-04-17 Ready for production 2020.04.16
    [control_board.kicad_pcb, control_board.sch, relay_board.kicad_pcb, relay_board.sch]
2020-05-05 Add one more dimension
    [control_board.kicad_pcb]
2020-05-05 Adding experimental button board
    [button_board.kicad_pcb, button_board.sch]
2020-07-06 Added background logo files
    [control_board.sch]
2020-10-22 Updating voltage regulator part.
    [relay_board.kicad_pcb, relay_board.sch]
2020-10-22 Actual BOM
    [patch_mate-bom.xlsx]
2020-12-25 Updating BOM.
    [patch_mate-bom.xlsx]
2021-01-17 Introducting patchmate board package.
2021-03-13 Splitting PatchMate and PatchMateX boards.
2021-12-10 Various fixes and improvements.
    [patch_mate-bom.xlsx]
2021-12-24 Change program with encoder.
2021-12-24 Removing outdated PatchMate8.
    [ControlBoard.fzz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]
2021-12-26 Fixing MIDI command extraction.
    For some SysEx data command() may return non-zero which lead to skip
    MIDI event by USB stack. Affects only MIDI->USB data pass.
    [midi_cmd.h]
